sunsun033/STM32H7LVGL/images/oshwhub_发布资料.md

# 立创开源（OSHWHub）发布资料

> 本文件是给「立创开源硬件平台」提交时直接复制粘贴用的。GitHub 版 README 见仓库根目录 `README.md`。

---

## 一、工程标题

```
基于STM32H743的RGB-LCD开发板 | 60帧LVGL + 32MB SDRAM + TF卡
```

> 标题规则：与项目相关、命名规范，输入后平台会自动生成拼音链接。
> 注意不要写成纯型号，要体现「是什么板子」，便于搜索。

## 二、工程标签（最多 3 个）

```
STM32    LVGL    开源硬件
```

备选：`RGB-LCD`、`SDRAM`、`开发板`、`Cortex-M7`
> 标签必须与项目实际属性相符，乱选会被审核拒绝。

## 三、工程简介（100 字以内）

```
基于STM32H743VIT6的RGB-LCD开源开发板，板载32MB SDRAM、SPI Flash与TF卡，集成RGB565屏接口与电容触摸。外设全部实测跑通：SDRAM@120MHz MemTest零错误，LVGL图形界面稳定60FPS，附完整原理图、源码与3D打印外壳，上手即用。
```

> 字数约 130 字，**如果平台限制 100 字，用下面这版**：

```
基于STM32H743VIT6的RGB-LCD开源开发板，板载32MB SDRAM、SPI Flash与TF卡，含RGB565屏与触摸接口。外设全实测：SDRAM@120MHz零错误，LVGL稳定60帧，附原理图、源码与3D外壳。
```

---

## 四、工程描述（教程级，直接粘贴）

> 立创审核重点看「描述是否全面」，教程级描述是评选优质工程的关键。

```markdown
## 一、项目简介

这是一块围绕「RGB-LCD 图形界面」场景设计的 STM32H743 开源开发板。

画这块板的初衷很实际：STM32H7 性能强，但想跑好一套 GUI，你必须同时解决三件事——**足够大的显存（SDRAM）、够用的存储（Flash + TF）、以及正确的 RGB 屏时序**。市面上很少有板子把这三样一次配齐，往往要自己飞线。所以我把它们做到了一块 60mm 见方的小板上，从硬件到驱动全部验证完毕再开源。

**一句话总结：到手即用的 H743 图形界面开发平台。**

## 二、功能特性

| 外设 | 型号 / 规格 | 实测状态 |
| --- | --- | --- |
| 主控 | STM32H743VIT6（LQFP144，Cortex-M7 @480MHz） | ✅ |
| SDRAM | W9825G6KH-6（Winbond，TSOP54，32MB） | ✅ 120MHz 下 MemTest **0 错误** |
| RGB-LCD | RGB565 接口，40pin FPC | ✅ LVGL 稳定 **59~60 FPS**，CPU 占用约 1% |
| 电容触摸 | TP 接口（I2C） | ✅ |
| SPI Flash | Winbond WSON8 | ✅ 读写正常 |
| TF 卡 | 卡座 | ✅ 读写正常 |
| 调试接口 | Type-C（DEBUG，供电 + USB 转串口） | ✅ |
| 串口 | Type-C（UART） | ✅ |
| 按键 | USER / RST / BOOT0 | ✅ |
| 指示灯 | POWER LED / SLED（串口状态） | ✅ |
| 扩展接口 | 2.54mm 双排排针（GPIO + 3.3V/5V/GND） | ✅ |

### 亮点说明

**1. SDRAM 跑在 120MHz，实测零错误**

SDRAM 用了 Winbond W9825G6KH-6（32MB）。这块片子标称 166MHz，我把它稳定跑到 120MHz 并长时间跑 MemTest，结果为 0 错误。这意味着你有充足的余量把 SDRAM 当显存用——LVGL 的多缓冲、全屏刷新都不再是瓶颈。

**2. LVGL 稳定 60 帧**

左上角可以看到 LVGL 的性能监视器：`59 FPS, 1% CPU, 3ms`。60Hz 是 RGB 屏的刷新上限，也就是说这块板子的刷屏能力已经**跑满屏的极限**，CPU 还几乎没占用，剩下的算力全都可以留给你的业务逻辑。

**3. 外设全部实测通过，不是「理论可用」**

所有外设都在实物上验证过，不是画完图就开源。配套白色 3D 打印外壳，装好就是一整机。

## 三、硬件设计说明

- **主控**：STM32H743VIT6，LQFP144 封装，480MHz Cortex-M7，双精度浮点
- **SDRAM 布线**：TSOP54 封装，注意等长与时钟线处理，保证 120MHz 下的信号完整性
- **显示接口**：40pin FPC 座，RGB565 直驱；背面预留 TP 触摸座（I2C）
- **供电**：Type-C 输入，板载 5V/3.3V 转换，带钽电容滤波
- **扩展**：右侧双排 2.54mm 排针，引出常用 GPIO 及 3.3V / 5V 供电

### GPIO 扩展口丝印

```
GND  3V   A13  A14  5V   A12  A11  C9   C8   C0
C6   C7   D13  D12  D11  B11  B10  C3   C2   C4
C5   A7   H3   H4   E6   ...
```

> 完整引脚分配以原理图为准。

## 四、实物验证

外壳为 3D 打印，装上后是一台完整的桌面小终端。图片见下方附件与工程图库。

**演示内容**：LVGL 完整 UI 演示（图像显示 + 亮度调节控件），全程稳定 59~60 FPS。

## 五、软件说明

- **开发环境**：Keil MDK / STM32CubeIDE（固件源码见附件）
- **图形库**：LVGL
- **BSP 驱动**：SDRAM、RGB-LCD、电容触摸、SPI Flash、TF 卡（FatFs）
- **上手流程**：
  1. Type-C 线接 `DEBUG` 口供电（同时可用作串口调试）
  2. 按住 `BOOT0` + 按一下 `RST` 可进入系统 Bootloader，实现串口下载
  3. 上电自动运行 LVGL 演示程序
  4. 二次开发直接基于 BSP 添加应用即可

## 六、注意事项 / 已知问题

1. RGB 屏为 **RGB565** 接口、40pin FPC，更换屏幕需按新屏时序修改 LCD 驱动参数
2. SDRAM 时钟设定为 120MHz，如需更高频率请自行验证信号完整性
3. 扩展口 IO 为 **3.3V 电平**，不可直接驱动 5V 器件或大电流负载
4. 触摸芯片型号请对照原理图 TP 部分标注

## 七、后续计划

- [ ] 补充完整引脚复用对照表
- [ ] 增加 LVGL 移植教程
- [ ] 增加 TF 卡 + FatFs 例程说明
- [ ] 开源 3D 打印外壳 STL 文件

## 八、开源协议

硬件：CERN-OHL-S ｜ 软件：MIT ｜ 文档：CC BY-SA 4.0

## 九、致谢

感谢嘉立创 EDA 提供的设计与打样支持。
```

---

## 五、附件准备清单

| 附件类型 | 文件 | 大小限制 | 说明 |
|---|---|---|---|
| 演示视频 | 微信视频2026-10-08_235308_753.mp4 | ≤50MB | **必须传**，优质工程硬指标 |
| 固件源码 | 工程压缩包 | ≤50MB | 建议附 Release bin |
| 原理图 PDF | 从嘉立创 EDA 导出 | ≤50MB | 方便他人快速浏览 |
| 3D 外壳 | STL / STEP | ≤50MB | **加分项**，你有白色外壳 |
| BOM | Excel / PDF | ≤50MB | 含立创商城编号更佳 |

> 提示：立创 EDA 工程本身在平台上就是开源的，原理图/PCB 源文件无需重复上传，但导出一份 PDF 更友好。

## 六、封面要求

- **比例 23:16**，**大小 ≤ 1MB**
- 建议用**实物图**或 **3D 渲染图**（审核项明确要求）
- 已为你生成 `oshwhub_cover.png`（1150×800，23:16 合规）

## 七、复刻成本（选填）

建议在发布页「复刻成本」处逐项填写元件单价，平台会自动求和。主要成本项：
- STM32H743VIT6
- W9825G6KH-6（SDRAM）
- Winbond SPI Flash
- TF 卡座 / Type-C 座 / FPC 座 / 排针
- 无源器件若干

## 八、审核避坑清单

根据立创官方审核标准，以下问题会导致**审核不通过**：

- ❌ 标题/简介/描述随意填写
- ❌ 无实物验证图、无电路设计图
- ❌ 设计图**不是嘉立创 EDA 画的**（你的板子是用嘉立创画的，✅ 没问题）
- ❌ 设计图与实物图不对应
- ❌ 标签与实际项目不符
- ❌ 含违规内容、负能量言论、过多无关广告
- ❌ 非完整工程（没做完、未验证实物）
- ❌ 转载/克隆未注明出处
- ❌ 未遵守所选开源协议

> **你的项目对照结果**：嘉立创 EDA 设计 ✅、实物验证 ✅、外观完整（带外壳）✅、演示视频 ✅、源码 ✅、设计文件 ✅ —— 完全具备冲击「优质工程」的条件，优质工程可获得首页推荐 + 公众号/B站流量扶持。
