sunsun033/STM32H7LVGL/PDF_STM32H743V2_2026-10-05/实验15 SDRAM实验/readme.txt

实验器材:
	阿波罗STM32H7开发板
	
实验目的:
	学习STM32通过FMC接口驱动SDRAM
	
硬件资源:
	1,DS0(连接在PB1) 
	2,按键KEY0(PH3)和KEY1(PH2)
	3,串口1(波特率:115200,PA9/PA10连接在板载USB转串口芯片CH340上面)
	4,ALIENTEK 2.8/3.5/4.3/7寸TFTLCD模块(仅限MCU屏，16位8080并口驱动) 
	5,外部SDRAM(W9825G6KH) 

实验现象:
	本实验开机后，显示提示信息，然后按下KEY0按键，即测试外部SDRAM容量大小并显示在LCD上。按
	下KEY1按键，即显示预存在外部SDRAM的数据。DS0指示程序运行状态。
	
注意事项:
	1,4.3寸和7寸屏需要比较大电流,USB供电可能不足,请用外部电源适配器(推荐外接12V 1A电源).
	2,本例程在LCD_Init函数里面(在lcd.c),用到了printf,如果不初始化串口1,将导致液晶无法显示!! 
	3,本例程仅支持MCU屏，不支持RGB屏！！
	4,对于没有MCU屏的朋友,请使用串口查看结果（使用开发板的USB转串口,波特率115200）

					正点原子@ALIENTEK
					2018-6-8
					广州市星翼电子科技有限公司
					电话：020-38271790
					传真：020-36773971
					购买：http://shop62103354.taobao.com
					http://shop62057469.taobao.com
					公司网站：www.alientek.com
					技术论坛：www.openedv.com
