sunsun033/STM32H7LVGL/images/oshwhub_cover.jpg

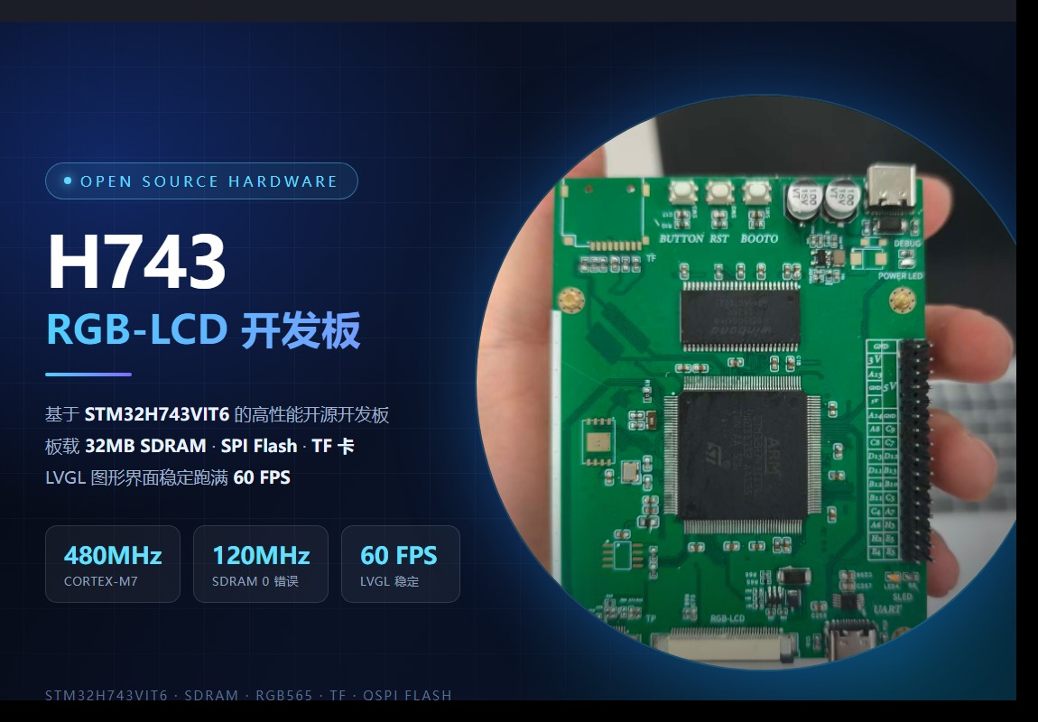
images/oshwhub_cover.jpg
