sunsun033/STM32H7LVGL/images/oshwhub_cover_raw.png

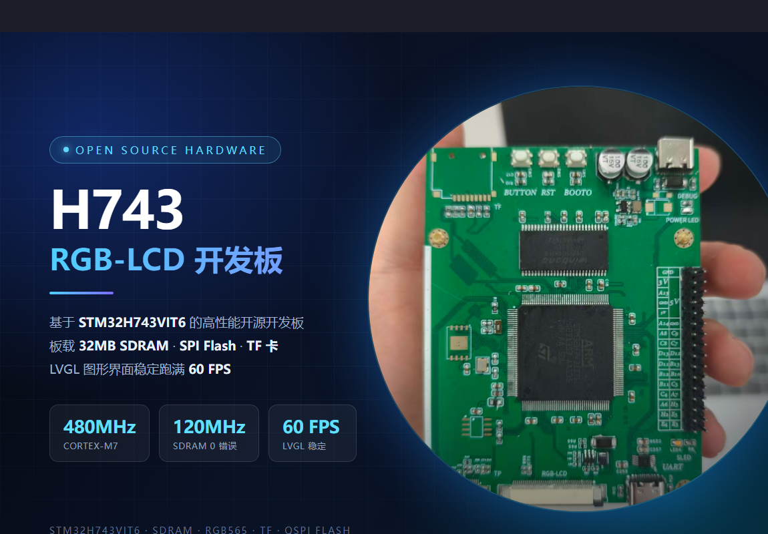
images/oshwhub_cover_raw.png
