sunsun033/STM32H7LVGL/STM32H7_LCD/image/background1.png

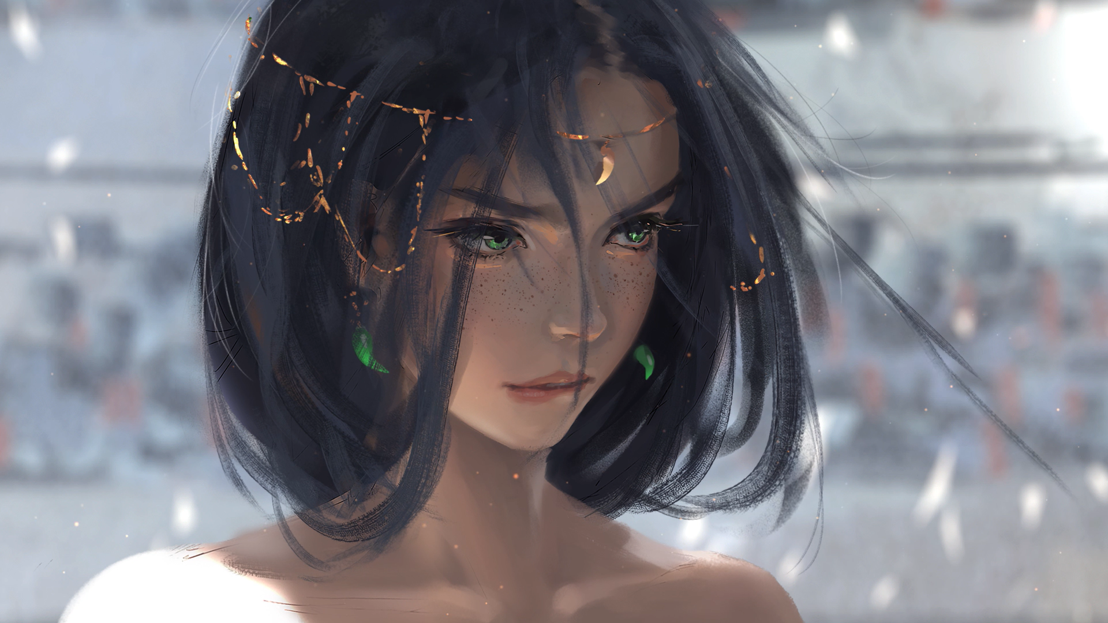
STM32H7_LCD/image/background1.png
