sunsun033/STM32H7LVGL/STM32H7_LCD/image/LED.png

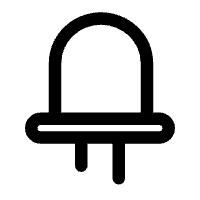
STM32H7_LCD/image/LED.png
