sunsun033/STM32H7LVGL/STM32H7_LCD/image/light.png

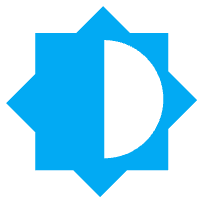
STM32H7_LCD/image/light.png
