sunsun033/STM32H7LVGL/BOM_核心板_核心板_2026-10-03.xlsx

No. | Quantity | Comment | Designator | Footprint | Value | Manufacturer Part | Manufacturer | Supplier Part | Supplier
1 | 27 | 100nF | C1,C2,C3,C4,C5,C6,C7,C8,C9,C10,C11,C12,C16,C17,C18,C31,C32,C33,C34,C35,C36,C37,C38,C42,C47,C48,C49 | C0603 | 100nF | CL10B104KB8NNNC | SAMSUNG(三星) | C1591 | LCSC
2 | 1 | 1uf | C13 | C0603 | 1uf | CL10B104KB8NNNC | SAMSUNG(三星) |  | LCSC
3 | 2 | 100uF | C14,C15 | CAP-SMD_BD6.3-L6.6-W6.6-FD | 100uF | VT1C101M0605 | ROQANG(容强) | C90273 | LCSC
4 | 2 | 2.2uF | C25,C26 | C0603 | 2.2uF | CL10A225KB8NNNC | SAMSUNG(三星) | C913904 | LCSC
5 | 2 | 12pF | C27,C28 | C0603 | 12pF | CL10C120JB8NNNC | SAMSUNG(三星) | C38523 | LCSC
6 | 2 | 9pF | C30,C50 | C0603 | 9pF | CC0603CRNPO9BN9R0 | YAGEO(国巨) | C282076 | LCSC
7 | 2 | 1uF | C59,C60 | C0402 | 1uF | CL05A105KP5NNNC | SAMSUNG(三星) | C14445 | LCSC
8 | 4 | 100nF | C73,C74,C76,C109 | C0402 | 100nF | CL05B104KO5NNNC | SAMSUNG(三星) | C1525 | LCSC
9 | 3 | 10uF | C75,C111,C112 | C0402 | 10uF | CL05A106MQ5NUNC | SAMSUNG(三星) | C15525 | LCSC
10 | 1 | NC | C110 | C0402 | NC | CL05B104KO5NNNC | SAMSUNG(三星) |  | LCSC
11 | 1 | 22pF | C113 | C0402 | 22pF | CGA0402C0G220J500GT | HRE(芯声) | C42371856 | LCSC
12 | 2 | 100nf | C256,C258 | C0603 | 100nf
13 | 1 | 10uf | C257 | C0603 | 10uf
14 | 1 | TF PUSH | CARD1 | TF-SMD_TF-PUSH |  | TF PUSH | SHOU HAN(首韩) | C393941 | LCSC
15 | 1 | SMBJ3.3A | D2 | SMB_L4.6-W3.6-LS5.3-RD |  | SMBJ3.3A | JKSEMI(金开盛) | C362089 | LCSC
16 | 1 | SMF5.0A | D3 | SOD-123FL_L2.7-W1.8-LS3.8-RD |  | SMF5.0A | FUXINSEMI(富芯森美) | C908213 | LCSC
17 | 2 | SS34 | D4,D9 | SMA_L4.3-W2.6-LS5.2-RD |  | SS34 | MDD(辰达半导体) | C8678 | LCSC
18 | 1 | 0.5K-AS-40PWBG | FPC2 | FPC-SMD_40P-P0.50_0.5K-AS-40PWB |  | 0.5K-AS-40PWBG | HDGC(华德共创) | C2911822 | LCSC
19 | 1 | AFC07-S06FCC-00 | FPC3 | FPC-SMD_P0.50-6P_LSSJ-H2.0-6P |  | AFC07-S06FCC-00 | JS(钜硕电子) | C11048 | LCSC
20 | 1 | PZ254V-12-8P | H1 | 2.54 2X8P |  | PZ254V-12-8P | XFCN(兴飞) | C492421 | LCSC
21 | 1 | HDR-M_2.54_2x10 | H2 | HDR-TH_20P-P2.54-V-M-R2-C10-S2.54
22 | 1 | HDR-M_2.54_2x2 | H3 | HDR-TH_4P-P2.54-V-M-R2-C2-S2.54-1 |  |  |  | C160338
23 | 1 | YI201209U121-5R0T | L2 | L0805 |  | YI201209U121-5R0T | YJYCOIN(益嘉源) | C2971889 | LCSC
24 | 1 | 22uH | L9 | IND-SMD_L2.5-W2.0_SWPA252012S | 22uH | SWPA252012S220MT | Sunlord(顺络) | C65856 | LCSC
25 | 1 | 2.2uH | L12 | IND-SMD_L2.5-W2.0-1 | 2.2uH | WPN252010U2R2MT | Sunlord(顺络) | C279871 | LCSC
26 | 2 | LED_0603-R | LED4,LED5 | LED_0603
27 | 1 | 0 | R1 | R0603 | 0
28 | 1 | 4.7kΩ | R3 | R0603 | 4.7kΩ | RC0603FR-074K7L | YAGEO(国巨) | C99782 | LCSC
29 | 9 | 10kΩ | R4,R5,R6,R10,R18,R19,R20,R21,R22 | R0603 | 10kΩ | 0603WAF1002T5E | UNI-ROYAL(厚声) | C25804 | LCSC
30 | 1 | 1k | R8 | R0603 | 1k | 0603WAF3301T5E | UNI-ROYAL(厚声) |  | LCSC
31 | 2 | 0Ω | R9,R64 | R0402 | 0Ω | 0402WGF0000TCE | UNI-ROYAL(厚声) | C17168 | LCSC
32 | 2 | 5.1K | R13,R14 | R0603 | 5.1K
33 | 4 | 5.1kΩ | R15,R16,R23,R24 | R0603 | 5.1kΩ | 0603WAF5101T5E | UNI-ROYAL(厚声) | C23186 | LCSC
34 | 5 | 10kΩ | R42,R43,R68,R70,R71 | R0402 | 10kΩ | 0402WGF1002TCE | UNI-ROYAL(厚声) | C25744 | LCSC
35 | 2 | NC | R63,R69 | R0402 | NC | 0402WGF4701TCE | UNI-ROYAL(厚声) |  | LCSC
36 | 2 | 16Ω | R65,R66 | R0402 | 16Ω | FRC0402F16R0TS | FOJAN(富捷) | C2909324 | LCSC
37 | 2 | 100kΩ | R67,R120 | R0402 | 100kΩ | 0402WGF1003TCE | UNI-ROYAL(厚声) | C25741 | LCSC
38 | 1 | 22.1kΩ | R123 | R0402 | 22.1kΩ | FRC0402F2212TS | FOJAN(富捷) | C2929993 | LCSC
39 | 3 | HX 3x4x2.5PA-B 160gf | SW1,SW2,SW3 | SW-SMD_4P-L4.2-W3.4-P2.15-LS5.2 |  | HX 3x4x2.5PA-B 160gf | hanxia(韩下) | C41427503 | LCSC
40 | 4 | M3螺丝孔 | T1,T2,T3,T4 | M3螺丝孔
41 | 1 | STM32H743IIT6 | U1 | LQFP_176 |  | STM32H743IIT6 | ST(意法半导体) | C89597 | LCSC
42 | 1 | MT9284-28J | U3 | SOT-23-6_L2.9-W1.6-P0.95-LS2.8-BR |  | MT9284-28J | 西安航天民芯 | C181780 | LCSC
43 | 1 | W9825G6KH-6 | U4 | TSOP-54_L22.2-W10.2-P0.80-LS11.8-BL |  | W9825G6KH-6 | WINBOND(华邦) | C62246 | LCSC
44 | 1 | W25Q128JVEIQ | U7 | WSON-8_L6.0-W8.0-P1.27-BL-EP |  | W25Q128JVEIQ | WINBOND(华邦) | C401662 | LCSC
45 | 1 | JSM24C02 | U10 | SOP-8_L5.0-W4.0-P1.27-LS6.0-BL |  | JSM24C02 | JSMSEMI(杰盛微) | C2857178 | LCSC
46 | 1 | CH340E | U19 | MSOP-10_L3.0-W3.0-P0.50-LS5.0-BL |  | CH340E | WCH(南京沁恒) | C99652 | LCSC
47 | 1 | SY8089A1AAC | U25 | TSOT-23-5_L2.9-W1.6-P0.95-LS2.8-BR |  | SY8089A1AAC | silergy(矽力杰) | C479074 | LCSC
48 | 1 | TYPE-C 16PIN | USB1 | USB-C-SMD_TYPE-C-6PIN-2MD-073 |  | TYPE-C 16PIN | SHOU HAN(首韩) | C2765186 | LCSC
49 | 1 | USB_TYPE-C-16P | USB2 | USB_TYPE-C-16P
50 | 1 | 32.768kHz | X1 | FC-135R_L3.2-W1.5 | 32.768kHz | Q13FC1350000400 | EPSON(爱普生) | C32346 | LCSC
51 | 1 | 25MHz | X2 | CRYSTAL-SMD_4P-L3.2-W2.5-BL | 25MHz | S3226000151040 | JGHC(晶光华) |  | LCSC
