sunsun033/STM32H7LVGL/切片/零件6.STL

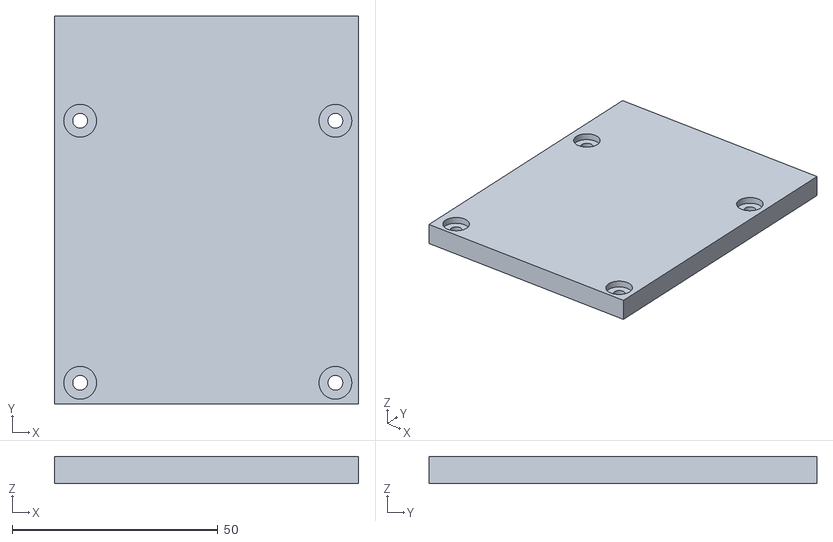
[picture p10: CAD file, 2026-10-09]
切片/零件6.STL
74.1 x 94.4 x 6.60
