sunsun033/STM32H7LVGL/images/test.jpg

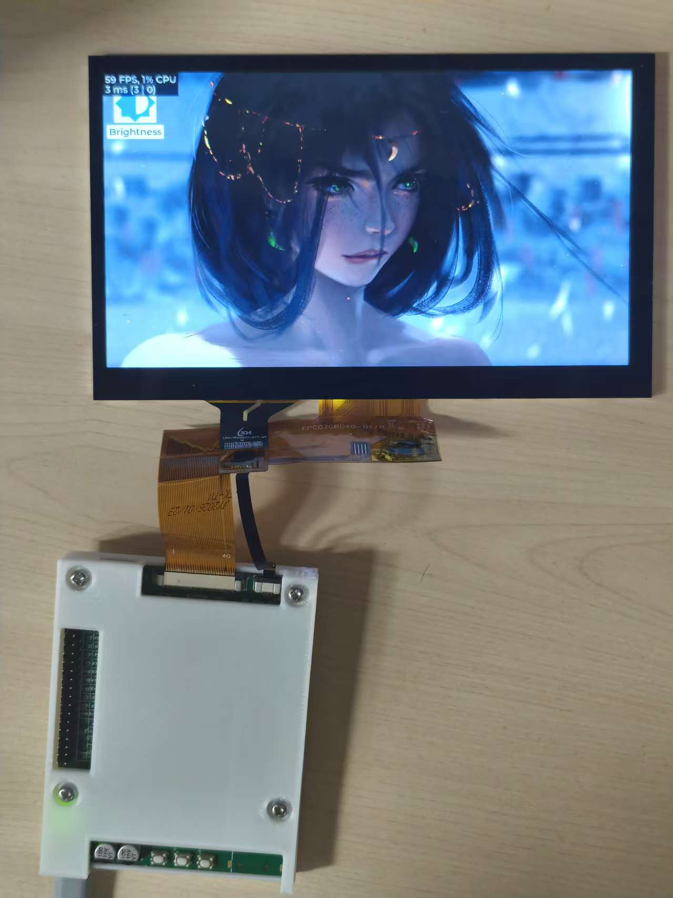
images/test.jpg
