sunsun033/STM32H7LVGL/PDF_STM32H743V2_2026-10-05/SCH_STM32H743V2_2-POWER_2026-10-05.pdf

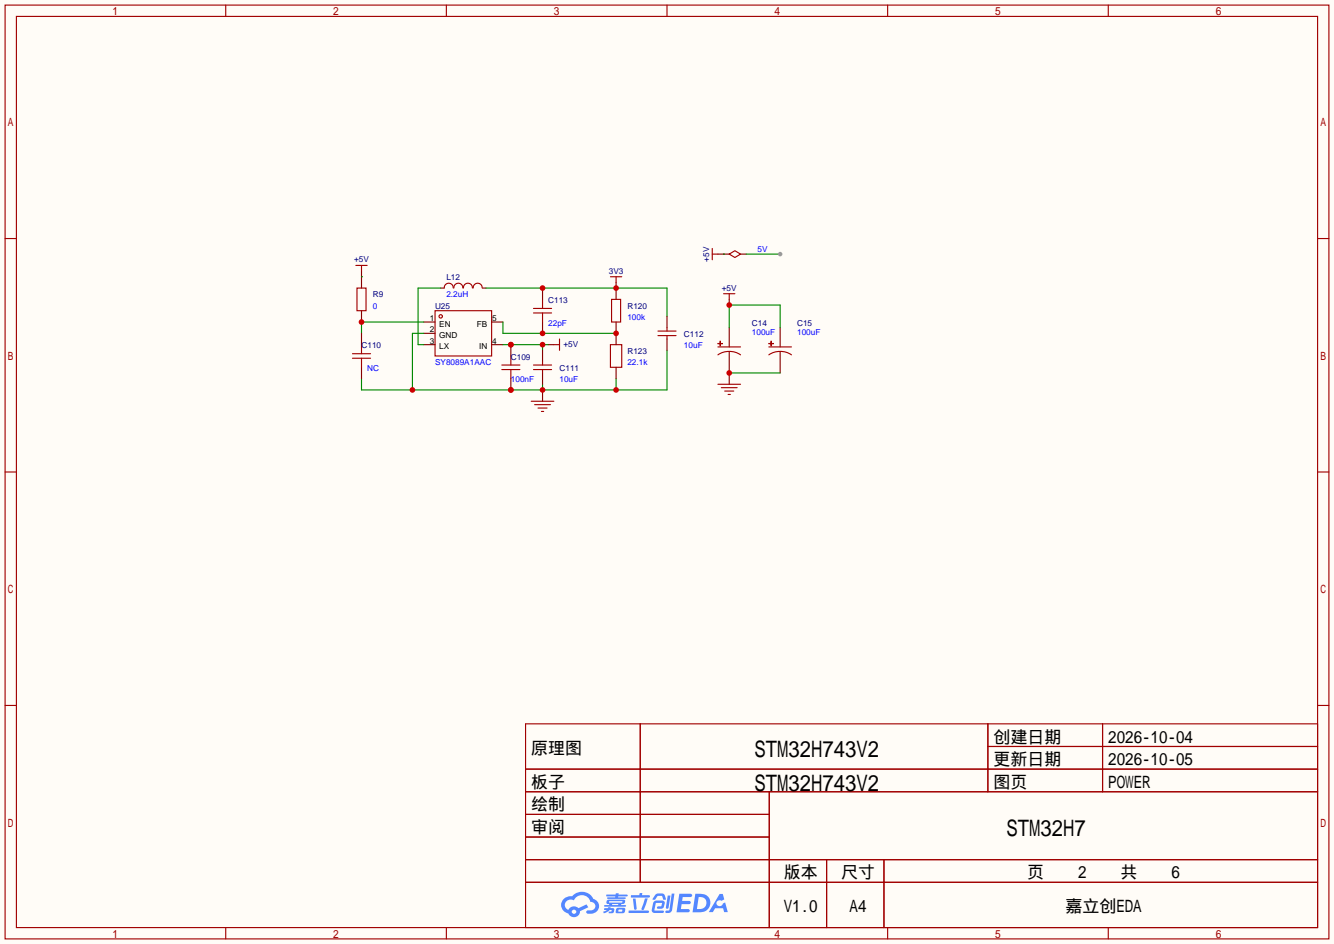
[picture p12: page 1]

原理图 | STM32H743V2 | 创建日期 | 2026-10-04
板子 | STM32H743V2 | 图页 | POWER
绘制 | | STM32H7
审阅

更新日期 | 2026-10-05

V1.0 | A4 | 嘉立创EDA
