sunsun033/STM32H7LVGL/PDF_STM32H743V2_2026-10-05/SCH_STM32H743V2_4-FLASH_2026-10-05.pdf

VDD 27 VSS 28 A4 29 A5 30 A6 31 A7 32 A8 33 A9 34 A11 35 A12 36 CKE 37 CLK 38 UDQM 39 NC 40 VSS 41 DQ8 42 VDDQ 43 DQ9 44 DQ10 45 VSSQ 46 DQ11 47 DQ12 48 VDDQ 49 DQ13 50 DQ14 51 VSSQ 52 DQ15 53 VSS 54

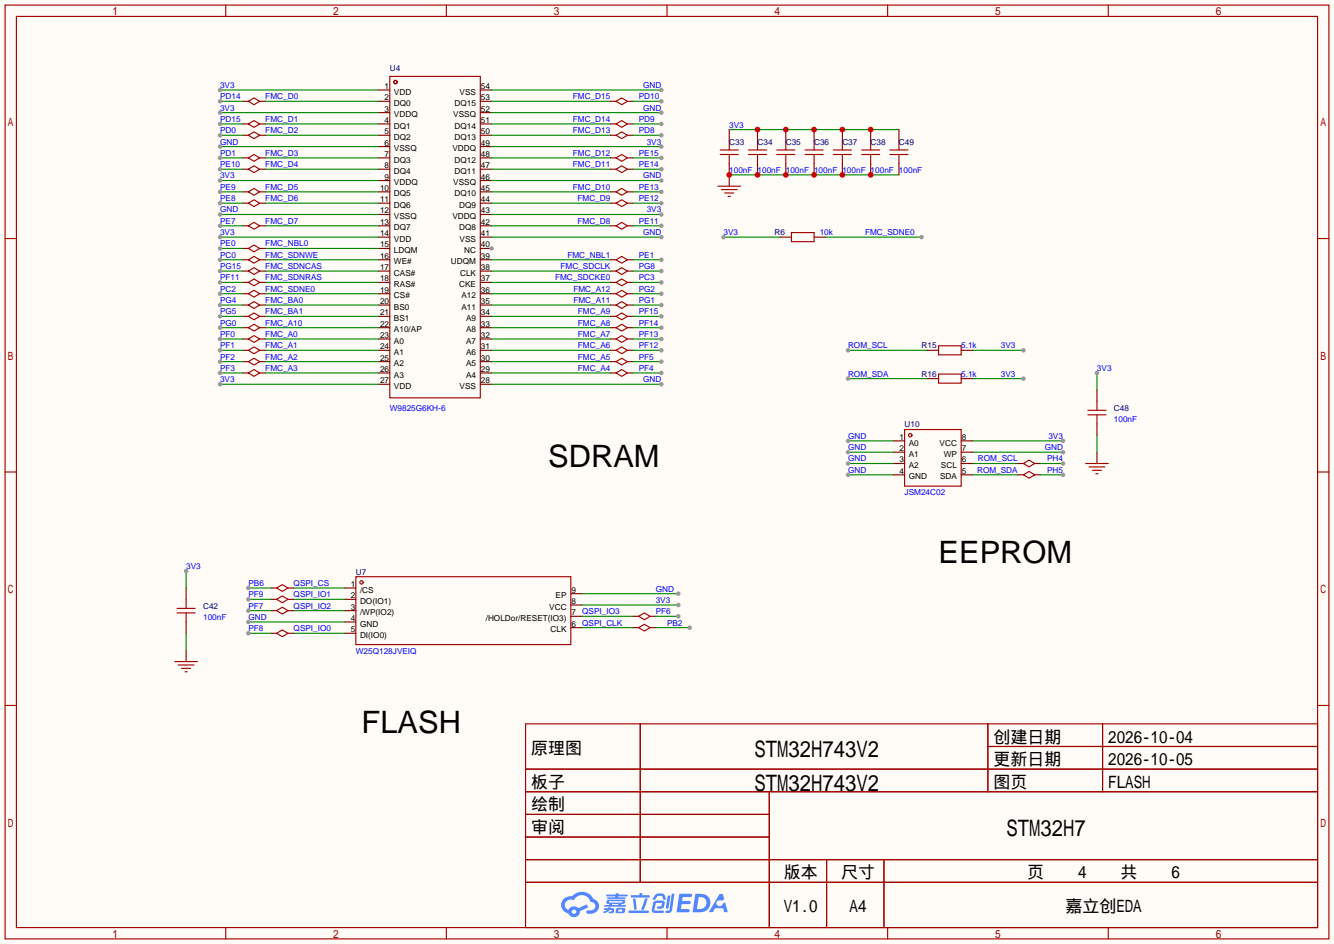
[picture p14: page 1]

原理图 | STM32H743V2 | 创建日期 | 2026-10-04
板子 | STM32H743V2 | 图页 | FLASH
绘制 | | STM32H7
审阅

更新日期 | 2026-10-05

V1.0 | A4 | 嘉立创EDA
