sunsun033/STM32H7LVGL/PDF_STM32H743V2_2026-10-05/SCH_STM32H743V2_1-MCU_2026-10-05.pdf

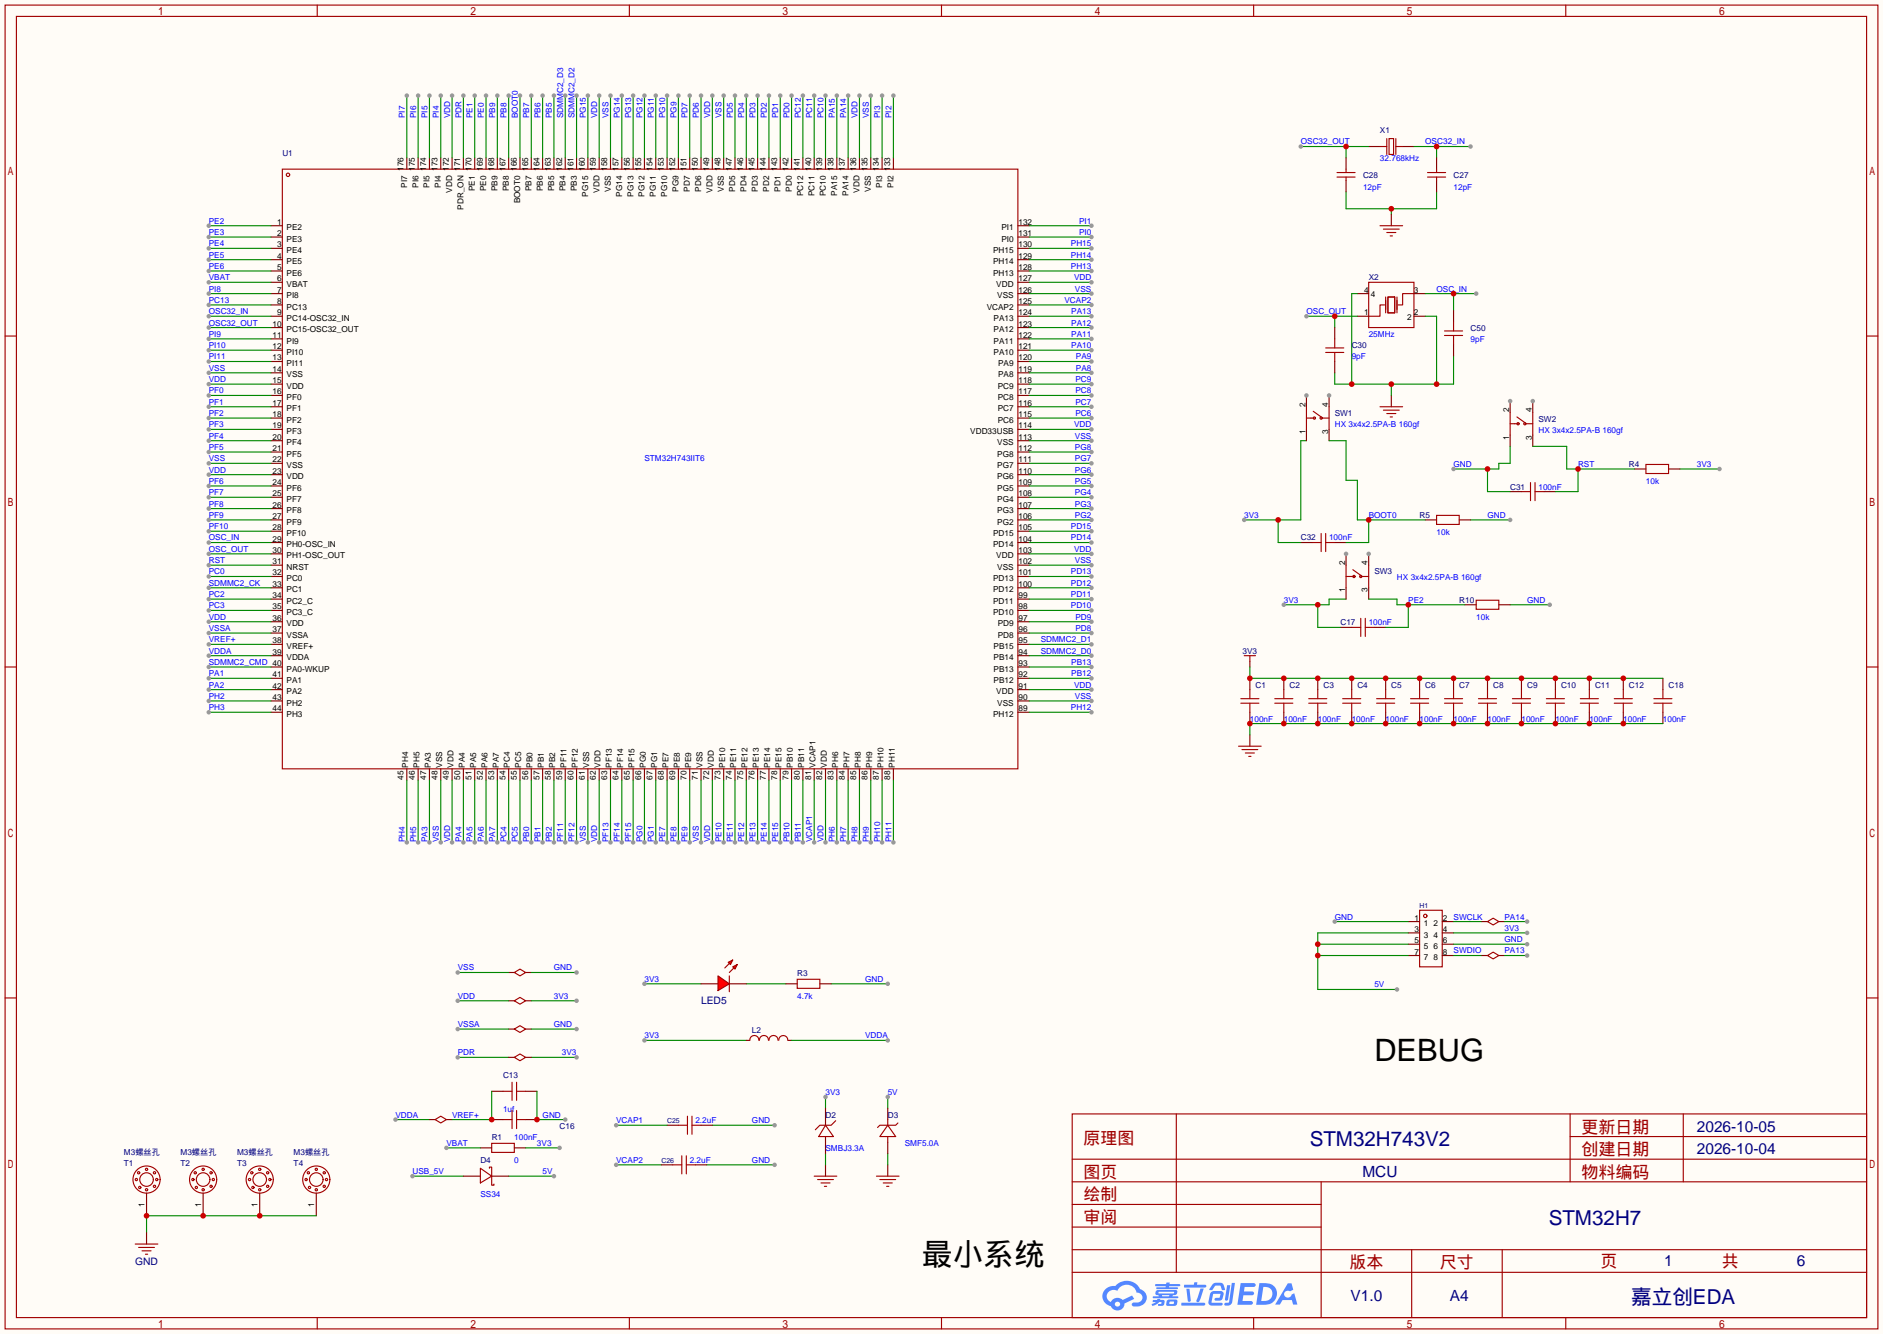
[picture p16: page 1]
