sunsun033/STM32H7LVGL/STM32H7_LCD/Project.ioc

Mcu.UserName=STM32H743IITx
PA10.Signal=USART1_RX
PA4.Signal=LTDC_VSYNC
PA9.Signal=USART1_TX
PB0.GPIO_Label=LCD_BL_EN
PB0.Signal=GPIO_Output
PC0.Signal=FMC_SDNWE
PC2_C.Signal=FMC_SDNE0
PC3_C.Signal=FMC_SDCKE0
PC6.Signal=LTDC_HSYNC
PD0.Signal=FMC_D2_DA2
PD1.Signal=FMC_D3_DA3
PD10.Signal=FMC_D15_DA15
PD14.Signal=FMC_D0_DA0
PD15.Signal=FMC_D1_DA1
PD8.Signal=FMC_D13_DA13
PD9.Signal=FMC_D14_DA14
PE0.Signal=FMC_NBL0
PE1.Signal=FMC_NBL1
PE10.Signal=FMC_D7_DA7
PE11.Signal=FMC_D8_DA8
PE12.Signal=FMC_D9_DA9
PE13.Signal=FMC_D10_DA10
PE14.Signal=FMC_D11_DA11
PE15.Signal=FMC_D12_DA12
PE7.Signal=FMC_D4_DA4
PE8.Signal=FMC_D5_DA5
PE9.Signal=FMC_D6_DA6
PF0.Signal=FMC_A0
PF1.Signal=FMC_A1
PF10.Signal=LTDC_DE
PF11.Signal=FMC_SDNRAS
PF12.Signal=FMC_A6
PF13.Signal=FMC_A7
PF14.Signal=FMC_A8
PF15.Signal=FMC_A9
PF2.Signal=FMC_A2
PF3.Signal=FMC_A3
PF4.Signal=FMC_A4
PF5.Signal=FMC_A5
PG0.Signal=FMC_A10
PG1.Signal=FMC_A11
PG10.Signal=LTDC_B2
PG11.Signal=LTDC_B3
PG14.GPIO_Label=LCD_TP_RST
PG14.Signal=GPIO_Output
PG15.Signal=FMC_SDNCAS
PG2.Signal=FMC_A12
PG4.Signal=FMC_A14_BA0
PG5.Signal=FMC_A15_BA1
PG6.Signal=LTDC_R7
PG7.Signal=LTDC_CLK
PG8.Signal=FMC_SDCLK
PH10.Signal=LTDC_R4
PH11.Signal=LTDC_R5
PH12.Signal=LTDC_R6
PH13.Signal=LTDC_G2
PH14.Signal=LTDC_G3
PH15.Signal=LTDC_G4
PH4.Signal=I2C2_SCL
PH5.Signal=I2C2_SDA
PH8.Signal=LTDC_R2
PH9.Signal=LTDC_R3
PI0.Signal=LTDC_G5
PI1.Signal=LTDC_G6
PI10.GPIO_Label=LED
PI10.Signal=GPIO_Output
PI2.Signal=LTDC_G7
PI3.GPIO_Label=LCD_TP_INT
PI3.Signal=GPIO_Input
PI4.Signal=LTDC_B4
PI5.Signal=LTDC_B5
PI6.Signal=LTDC_B6
PI7.Signal=LTDC_B7
