sunsun033/STM32H7LVGL/STM32H7_LCD/Core/Inc/main.h

#define LED_Pin GPIO_PIN_10
#define LED_GPIO_Port GPIOI
#define LCD_BL_EN_Pin GPIO_PIN_0
#define LCD_BL_EN_GPIO_Port GPIOB
#define LCD_TP_INT_Pin GPIO_PIN_3
#define LCD_TP_INT_GPIO_Port GPIOI
#define LCD_TP_RST_Pin GPIO_PIN_14
#define LCD_TP_RST_GPIO_Port GPIOG
