sunsun033/STM32H7LVGL/STM32H7_LCD/Core/Src/ltdc.c

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
/* Includes ------------------------------------------------------------------*/
#include "ltdc.h"

/* USER CODE BEGIN 0 */

/* ★ 像素格式的唯一出处（RGB565 / LCD_BPP 等）。故意放在 USER CODE 区里 ——
   CubeMX 重新生成 ltdc.c 时只覆盖它自己的区域，这个 include 不会丢。 */
#include "lcd_format.h"

/* USER CODE END 0 */

LTDC_HandleTypeDef hltdc;

/* LTDC init function */
void MX_LTDC_Init(void)
{

  LTDC_LayerCfgTypeDef pLayerCfg = {0};

  hltdc.Instance = LTDC;
  hltdc.Init.HSPolarity = LTDC_HSPOLARITY_AL;
  hltdc.Init.VSPolarity = LTDC_VSPOLARITY_AL;
  hltdc.Init.DEPolarity = LTDC_DEPOLARITY_AL;
  hltdc.Init.PCPolarity = LTDC_PCPOLARITY_IPC;
  hltdc.Init.HorizontalSync = 0;
  hltdc.Init.VerticalSync = 0;
  hltdc.Init.AccumulatedHBP = 46;
  hltdc.Init.AccumulatedVBP = 23;
  hltdc.Init.AccumulatedActiveW = 846;
  hltdc.Init.AccumulatedActiveH = 503;
  hltdc.Init.TotalWidth = 1056;
  hltdc.Init.TotalHeigh = 525;
  hltdc.Init.Backcolor.Blue = 0;
  hltdc.Init.Backcolor.Green = 0;
  hltdc.Init.Backcolor.Red = 0;
  if (HAL_LTDC_Init(&hltdc) != HAL_OK)
  {
    Error_Handler();
  }
  pLayerCfg.WindowX0 = 0;
  pLayerCfg.WindowX1 = 799;
  pLayerCfg.WindowY0 = 0;
  pLayerCfg.WindowY1 = 479;
  pLayerCfg.PixelFormat = LTDC_PIXEL_FORMAT_ARGB8888;
  pLayerCfg.Alpha = 255;
  pLayerCfg.Alpha0 = 0;
  pLayerCfg.BlendingFactor1 = LTDC_BLENDING_FACTOR1_CA;
  pLayerCfg.BlendingFactor2 = LTDC_BLENDING_FACTOR2_CA;
  pLayerCfg.FBStartAdress = 0xC0000000;
  pLayerCfg.ImageWidth = 800;
  pLayerCfg.ImageHeight = 480;
  pLayerCfg.Backcolor.Blue = 0;
  pLayerCfg.Backcolor.Green = 0;
  pLayerCfg.Backcolor.Red = 0;
  if (HAL_LTDC_ConfigLayer(&hltdc, &pLayerCfg, 0) != HAL_OK)
  {
    Error_Handler();
  }
  /* USER CODE BEGIN LTDC_Init 2 */

  /* ★★ 像素格式由代码说了算，CubeMX 里配的是什么都不影响 ★★
     上面 pLayerCfg.PixelFormat 是 CubeMX 生成的（可能在 CubeMX 里被配成
     ARGB8888），这里再覆盖成 lcd_format.h 里定义的格式。

     这段必须留在 USER CODE 区：CubeMX 重新生成 ltdc.c 时它不会被删，
     所以即使不动 CubeMX 的配置，格式也永远是对的。

     HAL_LTDC_SetPixelFormat() 内部会调用 LTDC_SetConfig()，
     把 LxPFCR（格式）和 LxCFBLR（每行字节数，16bpp 是 800*2）一起重算，
     并立刻 SRCR=IMR 生效 —— 等效于按新格式重新 ConfigLayer 一次。 */
  if (pLayerCfg.PixelFormat != LCD_PIXEL_FORMAT)
  {
    if (HAL_LTDC_SetPixelFormat(&hltdc, LCD_PIXEL_FORMAT, 0U) != HAL_OK)
    {
      Error_Handler();
    }
  }

  /* USER CODE END LTDC_Init 2 */

}

void HAL_LTDC_MspInit(LTDC_HandleTypeDef* ltdcHandle)
{

  GPIO_InitTypeDef GPIO_InitStruct = {0};
  RCC_PeriphCLKInitTypeDef PeriphClkInitStruct = {0};
  if(ltdcHandle->Instance==LTDC)
  {
  /** Initializes the peripherals clock
  */
    PeriphClkInitStruct.PeriphClockSelection = RCC_PERIPHCLK_LTDC;
    PeriphClkInitStruct.PLL3.PLL3M = 5;
    PeriphClkInitStruct.PLL3.PLL3N = 80;
    PeriphClkInitStruct.PLL3.PLL3P = 2;
    PeriphClkInitStruct.PLL3.PLL3Q = 2;
    PeriphClkInitStruct.PLL3.PLL3R = 12;
    PeriphClkInitStruct.PLL3.PLL3RGE = RCC_PLL3VCIRANGE_2;
    PeriphClkInitStruct.PLL3.PLL3VCOSEL = RCC_PLL3VCOWIDE;
    PeriphClkInitStruct.PLL3.PLL3FRACN = 0;
    if (HAL_RCCEx_PeriphCLKConfig(&PeriphClkInitStruct) != HAL_OK)
    {
      Error_Handler();
    }

    /* LTDC clock enable */
    __HAL_RCC_LTDC_CLK_ENABLE();

    __HAL_RCC_GPIOF_CLK_ENABLE();
    __HAL_RCC_GPIOA_CLK_ENABLE();
    __HAL_RCC_GPIOH_CLK_ENABLE();
    __HAL_RCC_GPIOG_CLK_ENABLE();
    __HAL_RCC_GPIOC_CLK_ENABLE();
    __HAL_RCC_GPIOI_CLK_ENABLE();
    /**LTDC GPIO Configuration
    PF10     ------> LTDC_DE
    PA4     ------> LTDC_VSYNC
    PH8     ------> LTDC_R2
    PH9     ------> LTDC_R3
    PH10     ------> LTDC_R4
    PH11     ------> LTDC_R5
    PH12     ------> LTDC_R6
    PG6     ------> LTDC_R7
    PG7     ------> LTDC_CLK
    PC6     ------> LTDC_HSYNC
    PH13     ------> LTDC_G2
    PH14     ------> LTDC_G3
    PH15     ------> LTDC_G4
    PI0     ------> LTDC_G5
    PI1     ------> LTDC_G6
    PI2     ------> LTDC_G7
    PG10     ------> LTDC_B2
    PG11     ------> LTDC_B3
    PI4     ------> LTDC_B4
    PI5     ------> LTDC_B5
    PI6     ------> LTDC_B6
    PI7     ------> LTDC_B7
    */
    GPIO_InitStruct.Pin = GPIO_PIN_10;
    GPIO_InitStruct.Mode = GPIO_MODE_AF_PP;
    GPIO_InitStruct.Pull = GPIO_NOPULL;
    GPIO_InitStruct.Speed = GPIO_SPEED_FREQ_VERY_HIGH;
    GPIO_InitStruct.Alternate = GPIO_AF14_LTDC;
    HAL_GPIO_Init(GPIOF, &GPIO_InitStruct);

    GPIO_InitStruct.Pin = GPIO_PIN_4;
    GPIO_InitStruct.Mode = GPIO_MODE_AF_PP;
    GPIO_InitStruct.Pull = GPIO_NOPULL;
    GPIO_InitStruct.Speed = GPIO_SPEED_FREQ_VERY_HIGH;
    GPIO_InitStruct.Alternate = GPIO_AF14_LTDC;
    HAL_GPIO_Init(GPIOA, &GPIO_InitStruct);

    GPIO_InitStruct.Pin = GPIO_PIN_8|GPIO_PIN_9|GPIO_PIN_10|GPIO_PIN_11
                          |GPIO_PIN_12;
    GPIO_InitStruct.Mode = GPIO_MODE_AF_PP;
    GPIO_InitStruct.Pull = GPIO_NOPULL;
    GPIO_InitStruct.Speed = GPIO_SPEED_FREQ_VERY_HIGH;
    GPIO_InitStruct.Alternate = GPIO_AF14_LTDC;
    HAL_GPIO_Init(GPIOH, &GPIO_InitStruct);

    GPIO_InitStruct.Pin = GPIO_PIN_6|GPIO_PIN_7|GPIO_PIN_10|GPIO_PIN_11;
    GPIO_InitStruct.Mode = GPIO_MODE_AF_PP;
    GPIO_InitStruct.Pull = GPIO_NOPULL;
    GPIO_InitStruct.Speed = GPIO_SPEED_FREQ_VERY_HIGH;
    GPIO_InitStruct.Alternate = GPIO_AF14_LTDC;
    HAL_GPIO_Init(GPIOG, &GPIO_InitStruct);

    GPIO_InitStruct.Pin = GPIO_PIN_6;
    GPIO_InitStruct.Mode = GPIO_MODE_AF_PP;
    GPIO_InitStruct.Pull = GPIO_NOPULL;
    GPIO_InitStruct.Speed = GPIO_SPEED_FREQ_VERY_HIGH;
    GPIO_InitStruct.Alternate = GPIO_AF14_LTDC;
    HAL_GPIO_Init(GPIOC, &GPIO_InitStruct);

    GPIO_InitStruct.Pin = GPIO_PIN_13|GPIO_PIN_14|GPIO_PIN_15;
    GPIO_InitStruct.Mode = GPIO_MODE_AF_PP;
    GPIO_InitStruct.Pull = GPIO_NOPULL;
    GPIO_InitStruct.Speed = GPIO_SPEED_FREQ_LOW;
    GPIO_InitStruct.Alternate = GPIO_AF14_LTDC;
    HAL_GPIO_Init(GPIOH, &GPIO_InitStruct);

    GPIO_InitStruct.Pin = GPIO_PIN_0|GPIO_PIN_1|GPIO_PIN_2|GPIO_PIN_4
                          |GPIO_PIN_5|GPIO_PIN_6|GPIO_PIN_7;
    GPIO_InitStruct.Mode = GPIO_MODE_AF_PP;
    GPIO_InitStruct.Pull = GPIO_NOPULL;
    GPIO_InitStruct.Speed = GPIO_SPEED_FREQ_LOW;
    GPIO_InitStruct.Alternate = GPIO_AF14_LTDC;
    HAL_GPIO_Init(GPIOI, &GPIO_InitStruct);

  }
}

void HAL_LTDC_MspDeInit(LTDC_HandleTypeDef* ltdcHandle)
{

  if(ltdcHandle->Instance==LTDC)
  {
    /* Peripheral clock disable */
    __HAL_RCC_LTDC_CLK_DISABLE();

    /**LTDC GPIO Configuration
    PF10     ------> LTDC_DE
    PA4     ------> LTDC_VSYNC
    PH8     ------> LTDC_R2
    PH9     ------> LTDC_R3
    PH10     ------> LTDC_R4
    PH11     ------> LTDC_R5
    PH12     ------> LTDC_R6
    PG6     ------> LTDC_R7
    PG7     ------> LTDC_CLK
    PC6     ------> LTDC_HSYNC
    PH13     ------> LTDC_G2
    PH14     ------> LTDC_G3
    PH15     ------> LTDC_G4
    PI0     ------> LTDC_G5
    PI1     ------> LTDC_G6
    PI2     ------> LTDC_G7
    PG10     ------> LTDC_B2
    PG11     ------> LTDC_B3
    PI4     ------> LTDC_B4
    PI5     ------> LTDC_B5
    PI6     ------> LTDC_B6
    PI7     ------> LTDC_B7
    */
    HAL_GPIO_DeInit(GPIOF, GPIO_PIN_10);

    HAL_GPIO_DeInit(GPIOA, GPIO_PIN_4);

    HAL_GPIO_DeInit(GPIOH, GPIO_PIN_8|GPIO_PIN_9|GPIO_PIN_10|GPIO_PIN_11
                          |GPIO_PIN_12|GPIO_PIN_13|GPIO_PIN_14|GPIO_PIN_15);

    HAL_GPIO_DeInit(GPIOG, GPIO_PIN_6|GPIO_PIN_7|GPIO_PIN_10|GPIO_PIN_11);

    HAL_GPIO_DeInit(GPIOC, GPIO_PIN_6);

    HAL_GPIO_DeInit(GPIOI, GPIO_PIN_0|GPIO_PIN_1|GPIO_PIN_2|GPIO_PIN_4
                          |GPIO_PIN_5|GPIO_PIN_6|GPIO_PIN_7);

  }
}
