sunsun033/STM32H7LVGL/STM32H7_LCD/BSP/Src/bsp_gt911.c

/**
  ******************************************************************************
  * @file    bsp_gt911.c
  * @brief   GT911 电容触摸屏驱动实现
  ******************************************************************************
  */
#include "bsp_gt911.h"
#include "bsp_i2c.h"

/* ------------------------- GT911 寄存器 ------------------------- */
#define GT911_REG_PRODUCT_ID    0x8140U   /* 4 字节："911" + 版本 */
#define GT911_REG_STATUS        0x814EU   /* bit7=有新数据, bit0-3=点数 */
#define GT911_REG_POINT1        0x814FU   /* 第 1 个点，每个点 8 字节 */

#define GT911_POINT_SIZE        8U

/* 当前使用的 I2C 地址（0 = 未探测到） */
static uint8_t s_gt911_addr = 0U;

/* ------------------------- INT 引脚方向切换 ------------------------- */

static void gt911_int_as_output(void)
{
    GPIO_InitTypeDef GPIO_InitStruct = {0};

    GPIO_InitStruct.Pin   = LCD_TP_INT_Pin;
    GPIO_InitStruct.Mode  = GPIO_MODE_OUTPUT_PP;
    GPIO_InitStruct.Pull  = GPIO_NOPULL;
    GPIO_InitStruct.Speed = GPIO_SPEED_FREQ_LOW;
    HAL_GPIO_Init(LCD_TP_INT_GPIO_Port, &GPIO_InitStruct);
}

static void gt911_int_as_input(void)
{
    GPIO_InitTypeDef GPIO_InitStruct = {0};

    GPIO_InitStruct.Pin   = LCD_TP_INT_Pin;
    GPIO_InitStruct.Mode  = GPIO_MODE_INPUT;
    GPIO_InitStruct.Pull  = GPIO_NOPULL;
    HAL_GPIO_Init(LCD_TP_INT_GPIO_Port, &GPIO_InitStruct);
}

/* ------------------------- 复位时序 ------------------------- */

/**
  * @brief  按 GT911 datasheet 时序复位，并用 INT 电平选择 I2C 地址
  * @param  int_high 0 = INT 拉低(选 0x5D)，1 = INT 拉高(选 0x14)
  */
static void gt911_hw_reset(uint8_t int_high)
{
    /* 1) INT 先设成输出，并输出目标电平 */
    gt911_int_as_output();
    HAL_GPIO_WritePin(LCD_TP_INT_GPIO_Port, LCD_TP_INT_Pin,
                      (int_high != 0U) ? GPIO_PIN_SET : GPIO_PIN_RESET);
    HAL_Delay(10U);

    /* 2) RST 拉低（>=10ms） */
    HAL_GPIO_WritePin(LCD_TP_RST_GPIO_Port, LCD_TP_RST_Pin, GPIO_PIN_RESET);
    HAL_Delay(20U);

    /* 3) 再次确保 INT 处于目标电平 —— RST 上升沿会被锁存 */
    HAL_GPIO_WritePin(LCD_TP_INT_GPIO_Port, LCD_TP_INT_Pin,
                      (int_high != 0U) ? GPIO_PIN_SET : GPIO_PIN_RESET);
    HAL_Delay(1U);

    /* 4) RST 拉高（>=100us），地址在此时被锁存 */
    HAL_GPIO_WritePin(LCD_TP_RST_GPIO_Port, LCD_TP_RST_Pin, GPIO_PIN_SET);
    HAL_Delay(2U);

    /* 5) INT 及时释放为输入（高阻） */
    gt911_int_as_input();

    /* 6) 等待 GT911 内部初始化完成（datasheet 要求 >=55ms，这里留足余量） */
    HAL_Delay(300U);
}

/* ------------------------- 对外接口 ------------------------- */

uint8_t bsp_gt911_get_addr(void)
{
    return s_gt911_addr;
}

uint8_t bsp_gt911_init(void)
{
    static const uint8_t addr_list[2]  = { GT911_I2C_ADDR_5D, GT911_I2C_ADDR_14 };
    static const uint8_t level_list[2] = { 0U, 1U };   /* 0=INT低->0x5D, 1=INT高->0x14 */
    uint8_t id[4];
    uint8_t i;
    uint8_t retry;

    s_gt911_addr = 0U;

    /* 两种地址各试一遍：先用 INT 电平复位，再读产品 ID */
    for (i = 0U; i < 2U; i++)
    {
        gt911_hw_reset(level_list[i]);

        for (retry = 0U; retry < 3U; retry++)
        {
            id[0] = 0U; id[1] = 0U; id[2] = 0U; id[3] = 0U;

            if (bsp_i2c_read16(addr_list[i], GT911_REG_PRODUCT_ID, id, 4U) == HAL_OK)
            {
                /* 产品 ID 前 3 字节应为 ASCII "911" */
                if ((id[0] == (uint8_t)'9') &&
                    (id[1] == (uint8_t)'1') &&
                    (id[2] == (uint8_t)'1'))
                {
                    s_gt911_addr = addr_list[i];
                    return 0U;
                }
            }
            HAL_Delay(20U);
        }
    }

    return 1U;   /* 未找到 GT911 */
}

uint8_t bsp_gt911_scan(gt911_touch_t *touch)
{
    uint8_t status = 0U;
    uint8_t buf[GT911_POINT_SIZE];
    uint8_t count;
    uint8_t i;
    uint16_t reg;

    if ((touch == NULL) || (s_gt911_addr == 0U))
    {
        return 0U;
    }

    touch->count = 0U;

    /* 1) 读状态寄存器，bit7=1 表示有新的触摸数据 */
    if (bsp_i2c_read16(s_gt911_addr, GT911_REG_STATUS, &status, 1U) != HAL_OK)
    {
        return 0U;
    }
    if ((status & 0x80U) == 0U)
    {
        return 0U;                       /* 没有新数据 */
    }

    count = (uint8_t)(status & 0x0FU);   /* bit0-3 = 触摸点数 */
    if (count > GT911_MAX_POINTS)
    {
        count = GT911_MAX_POINTS;
    }

    /* 2) 逐点读坐标：X/Y 都是低字节在前 */
    for (i = 0U; i < count; i++)
    {
        reg = (uint16_t)(GT911_REG_POINT1 + ((uint16_t)i * GT911_POINT_SIZE));

        if (bsp_i2c_read16(s_gt911_addr, reg, buf, GT911_POINT_SIZE) != HAL_OK)
        {
            count = i;                   /* 读失败就返回已读到的 */
            break;
        }

        /* buf[0]=track id, buf[1..2]=X, buf[3..4]=Y, buf[5..6]=size, buf[7]=保留 */
        touch->x[i] = (uint16_t)buf[1] | ((uint16_t)buf[2] << 8);
        touch->y[i] = (uint16_t)buf[3] | ((uint16_t)buf[4] << 8);
    }

    touch->count = count;

    /* 3) 写 0 清除状态标志，GT911 才会产生下一次上报 */
    status = 0U;
    (void)bsp_i2c_write16(s_gt911_addr, GT911_REG_STATUS, &status, 1U);

    return (count > 0U) ? 1U : 0U;
}
