sunsun033/STM32H7LVGL/(commit log)

2026-10-09 提交了相关的资料包括软件代码
2026-10-09 修改了readme文档
2026-10-09 docs: README 更换实机运行图与实物图，修复图片引用与链接
2026-10-09 更改了最新readme文档
2026-10-09 Update Type-C power supply description in README
