sunsun033/STM32H7LVGL/(notices)

Notices in the files:
PDF_STM32H743V2_2026-10-05/实验15 SDRAM实验/HARDWARE/TIMER/timer.c:
Copyright(C) ¹ãÖÝÊÐÐÇÒíµç×Ó¿Æ¼¼ÓÐÏÞ¹«Ë¾ 2014-2024
All rights reserved
STM32H7_LCD/Core/Src/dma2d.c:
Copyright (c) 2026 STMicroelectronics.
This software is licensed under terms that can be found in the LICENSE file
